kiu/SevenBlocks/bom.ods

Ordered | Description | Qty | Price | Price (sum) | Id | Link
x | Zahnrad Z18/M1/B4 | 29 | 0.60 € | 17.40 € | OT840044 | http://www.eiwa-es.de
x | 10x Kunststoffzahnstange Modul 1 | 3 | 2.60 € | 7.80 € | TR35.026.0 | http://www.eiwa-es.de
x | Shipping | 1 | 4.95 € | 4.95 € | - | http://www.eiwa-es.de
x | 600x300x3 black 9H01 | 3 |  |  | - | http://www.plexihandel.de
x | 600x300x3 red 3H01 | 3 |  |  | - | http://www.plexihandel.de
x | 600x300x3 transparent XT | 1 |  |  | - | http://www.plexihandel.de
x | Shipping | 1 |  |  | - | http://www.plexihandel.de
x | Sum | 1 | 78.00 € | 78.00 € | - | http://www.plexihandel.de
x | Laser usage (3h) | 1 | 100.00 € | 100.00 € | - | http://www.fablab-muenchen.de
x | ACRIFIX®, Klebstoff, 1S 0116 | 1 | 9.49 € | 9.49 € | - | http://www.ebay.de
x | Shipping | 1 | 3.50 € | 3.50 € | - | http://www.ebay.de
x | HXT500 | 29 | 2.66 € | 77.14 € | HXT500 | http://www.hobbyking.com
x | Shipping | 1 | 20.50 € | 20.50 € | - | http://www.hobbyking.com
x | Customs duty | 1 | 18.55 € | 18.55 € | - | http://www.hobbyking.com
x | 50X DIN 912 A2 M3X6 SB | 1 | 4.99 € | 4.99 € | 912236SB | http://www.screwsandmore.de
x | 25x DIN 912 A2 M4X8 SB | 1 | 4.49 € | 4.49 € | 912248SB | http://www.screwsandmore.de
x | 25x DIN 125 A2 3,2 SB | 1 | 1.49 € | 1.49 € | 125232SB | http://www.screwsandmore.de
x | 50x DIN 125 A2 3,2 SB | 2 | 2.49 € | 4.98 € | 125232SB | http://www.screwsandmore.de
x | Shipping | 1 | 4.50 € | 4.50 € | - | http://www.screwsandmore.de
x | 120x DIN 912 A2 M3x4 | 1 | 26.74 € | 26.74 € | 1448 | http://www.pfahl-verbindungstechnik.de
x | C-Control DCF-Empfängerplatine | 1 | 10.21 € | 10.21 € | 641138-62 | http://www.conrad.de
x | Pinhead 1x3 | 34 | 0.06 € | 2.04 € | 741565 | http://www.conrad.de
x | Pinhead 1x5 | 1 | 0.10 € | 0.10 € | 741605 | http://www.conrad.de
x | Pinhead 1x7 W | 1 | 0.26 € | 0.26 € | 733901 | http://www.conrad.de
x | Socket 1x5 | 1 | 0.42 € | 0.42 € | 732331 | http://www.conrad.de
x | Shipping | 1 | 5.95 € | 5.95 € | - | http://www.conrad.de
x | 10x PCB 50mmx50mm red | 3 | 15.60 € | 46.80 € | PCB08511P | http://www.seeedstudio.com/depot/fusion-pcb-service-p-835.html?cPath=185
x | Shipping | 1 |  |  | - | http://www.seeedstudio.com/depot/fusion-pcb-service-p-835.html?cPath=185
x | Customs duty | 1 | 8.89 € | 8.89 € | - | http://www.seeedstudio.com/depot/fusion-pcb-service-p-835.html?cPath=185
x | Lautsprecherlitze, 2x0,75mm², transp., 5m-Ring | 1 | 1.15 € | 1.15 € | LAT 275-5 | http://www.reichelt.de
x | Mini Schaltnetzteil, geschlossen, 5V/5,0A/25W | 1 | 10.40 € | 10.40 € | SNT MW25-05M | http://www.reichelt.de
x | Netzkabel m. Schutzkontaktstecker, 1,5m, schw. | 1 | 1.90 € | 1.90 € | NKS 150 SW | http://www.reichelt.de
x | SMD LM 75 | 1 | 1.45 € | 1.45 € | LM 75 SMD | http://www.reichelt.de | x | LM 75 | 1 | 1.45 € | 1.45 € | LM 75 SMD | http://www.reichelt.de | x | LM 75 | 1 | 1.45 € | 1.45 € | LM 75 SMD | http://www.reichelt.de | x | LM 75 | 1 | 1.45 € | 1.45 € | LM 75 SMD | http://www.reichelt.de | x | LM 75 | 1 | 1.45 € | 1.45 € | LM 75 SMD | http://www.reichelt.de | x | LM 75 | 1 | 1.45 € | 1.45 € | LM 75 SMD | http://www.reichelt.de | x | LM 75 | 1 | 1.45 € | 1.45 € | LM 75 SMD | http://www.reichelt.de | x | LM 75 | 1 | 1.45 € | 1.45 € | LM 75 SMD | http://www.reichelt.de | x | LM 75 | 1 | 1.45 €
x | SMD ATMega8 TQFP-32 | 2 | 2.30 € | 4.60 € | ATMEGA 8-16 TQ | http://www.reichelt.de
x | SMD 74HC595 | 4 | 0.26 € | 1.04 € | SMD HC 595 | http://www.reichelt.de
x | SMD 100nF | 14 | 0.05 € | 0.70 € | X7R-G0805 100N | http://www.reichelt.de
x | SMD 10nF | 8 | 0.05 € | 0.40 € | X7R-G0805 10N | http://www.reichelt.de
x | SMD Elko 100uF 5mm | 10 | 0.16 € | 1.60 € | VF 100/6,3 K-C | http://www.reichelt.de
x | SMD Elko 10uF 4mm | 8 | 0.09 € | 0.72 € | VF 10/16 C-B | http://www.reichelt.de
x | SMD 4k7 | 4 | 0.10 € | 0.40 € | SMD-0805 4,70K | http://www.reichelt.de
x | SMD 10k | 2 | 0.10 € | 0.20 € | SMD-0805 10,0K | http://www.reichelt.de
x | SMD 20k (only 18k available) | 1 | 0.10 € | 0.10 € | SMD-0805 18,0K | http://www.reichelt.de
x | Wannenstecker, 16-polig, gewinkelt | 9 | 0.16 € | 1.44 € | WSL 16W | http://www.reichelt.de
x | Wannenstecker, 10-polig, gewinkelt | 3 | 0.13 € | 0.39 € | WSL 10W | http://www.reichelt.de
x | Wannenstecker, 6-polig, gerade | 2 | 0.16 € | 0.32 € | WSL 6G | http://www.reichelt.de
x | Pfostenbuchse, 16-polig, mit Zugentlastung | 8 | 0.13 € | 1.04 € | PFL 16 | http://www.reichelt.de
x | Pfostenbuchse, 10-polig, mit Zugentlastung | 2 | 0.08 € | 0.16 € | PFL 10 | http://www.reichelt.de
x | Flachbandkabel AWG28, 16-pol., farb., 3m-Ring | 1 | 4.25 € | 4.25 € | AWG 28-16F 3M | http://www.reichelt.de
x | Flachbandkabel AWG28, 10-pol., farb., 3m-Ring | 1 | 3.00 € | 3.00 € | AWG 28-10F 3M | http://www.reichelt.de
x | Steckbare Anschlussklemme 2-polig, RM5mm | 1 | 0.44 € | 0.44 € | AKL 007-02 | http://www.reichelt.de
x | Stiftleiste für Anschlussklemme 2-polig, RM5mm | 1 | 0.24 € | 0.24 € | STL 017-02 | http://www.reichelt.de
x | Platinensteckverbinder gerade, braun, 3-polig | 2 | 0.34 € | 0.68 € | PS 25/3G BR | http://www.reichelt.de
x | Platinensteckverbinder gerade, braun, 5-polig | 1 | 0.56 € | 0.56 € | PS 25/5G BR | http://www.reichelt.de
x | Hirschmann-Sicherheitseinbaubuchse 4mm, rt | 1 | 1.90 € | 1.90 € | SEB 2600 RT | http://www.reichelt.de
x | Hirschmann-Sicherheitseinbaubuchse 4mm, sw | 1 | 1.90 € | 1.90 € | SEB 2600 SW | http://www.reichelt.de
x | Stufen-Drehschalter, 1 Pol, 12 Stellungen | 1 | 1.65 € | 1.65 € | DS 1 | http://www.reichelt.de
x | Aluminium-Geräteknopf für 6mm-Achse, schwarz | 1 | 1.85 € | 1.85 € | KNOPF 20-6 ALS | http://www.reichelt.de
x | Distanzhülsen, Metall, 6-Kant, M3, 8mm | 58 | 0.08 € | 4.87 € | DI 8MM | http://www.reichelt.de
x | Distanzhülsen, Metall, 6-Kant, M3, 10mm | 24 | 0.10 € | 2.30 € | DI 10MM | http://www.reichelt.de
x | Distanzhülsen, Metall, 6-Kant, M4, 15mm | 6 | 0.16 € | 0.96 € | DI4 15MM | http://www.reichelt.de
x | Distanzhülsen, Metall, 6-Kant, M4, 15mm | 14 | 0.22 € | 3.08 € | DA4 15MM | http://www.reichelt.de
x | Distanzhülsen, Metall, 6-Kant, M4, 20mm | 8 | 0.30 € | 2.40 € | DA4 20MM | http://www.reichelt.de
x | Kabelbinder | 1 | 0.99 € | 0.99 € | KAB-U 140-3,5 | http://www.reichelt.de
x | Shipping | 1 | 5.60 € | 5.60 € | - | http://www.reichelt.de
x | RTC | 1 | 15.00 € | 15.00 € | 281 | http://www.tinkersoup.de
x | Shipping | 1 | 4.50 € | 4.50 € | - | http://www.tinkersoup.de
 |  |  |  | SUM
 |  |  |  | 543.38 €
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
