kiu/SevenBlocks/acryl/laser-v1-protptype/muster.dxf

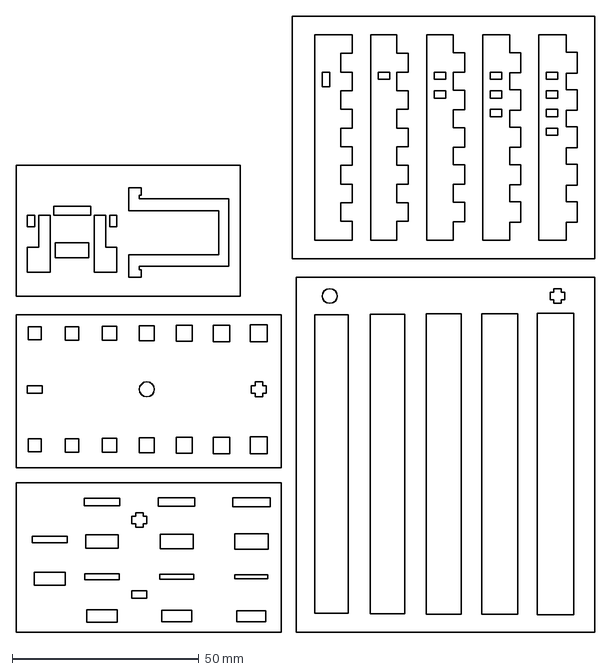
[picture p1: CAD file, 2012-04-07]
acryl/laser-v1-protptype/muster.dxf
155.0 x 165.0 mm
