kiu/SevenBlocks/acryl/laser-v2-design/sides.dxf

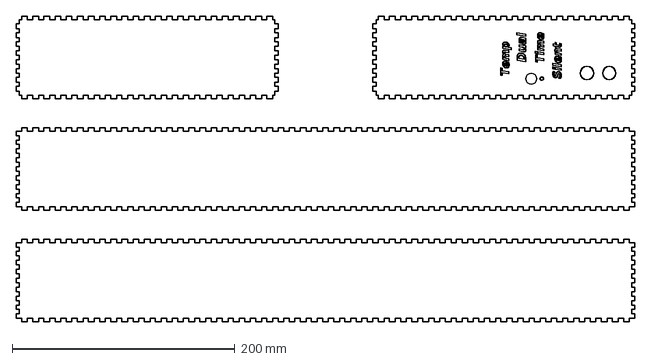
[picture p2: CAD file, 2012-04-07]
acryl/laser-v2-design/sides.dxf
555.0 x 274.0 mm
