kiu/SevenBlocks/acryl/laser-v3-final/red-01.dxf

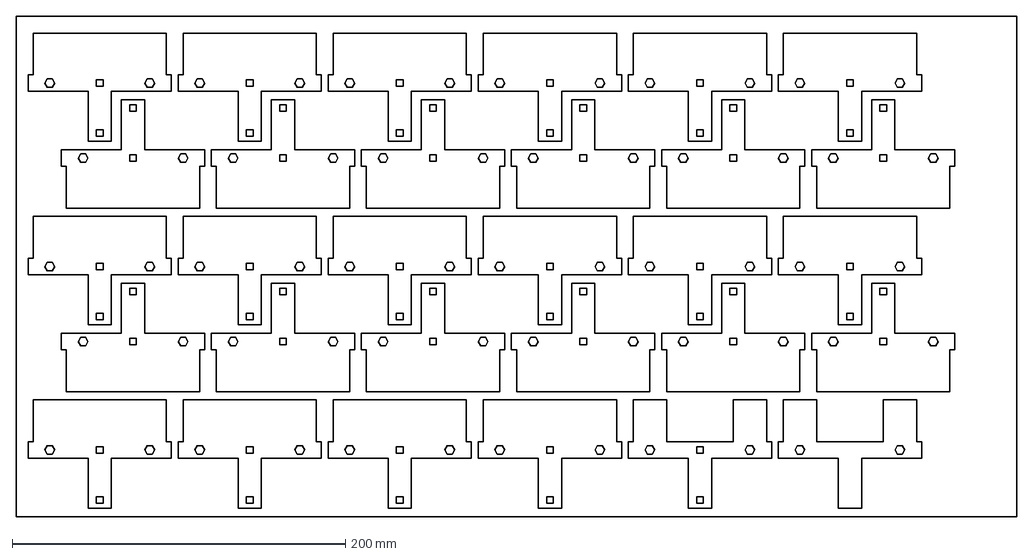
[picture p3: CAD file, 2012-04-07]
acryl/laser-v3-final/red-01.dxf
600.0 x 300.0 mm
