kiu/SevenBlocks/acryl/laser-v2-design/layers-single.dxf

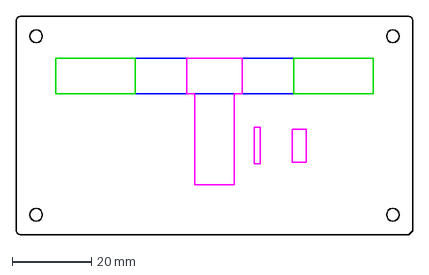
[picture p5: CAD file, 2012-04-07]
acryl/laser-v2-design/layers-single.dxf
100.0 x 55.0 mm
