kiu/SevenBlocks/acryl/laser-v1-protptype/plate2.dxf

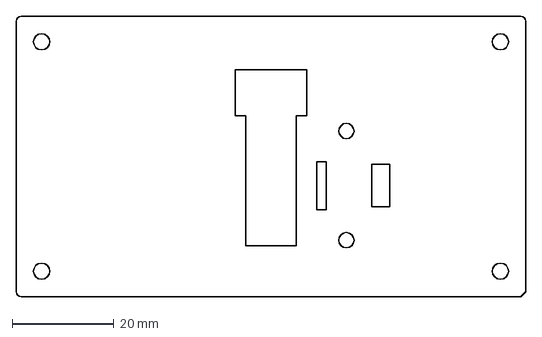
[picture p7: CAD file, 2012-04-07]
acryl/laser-v1-protptype/plate2.dxf
100.0 x 55.0 mm
