kiu/SevenBlocks/acryl/laser-v2-design/layers.dxf

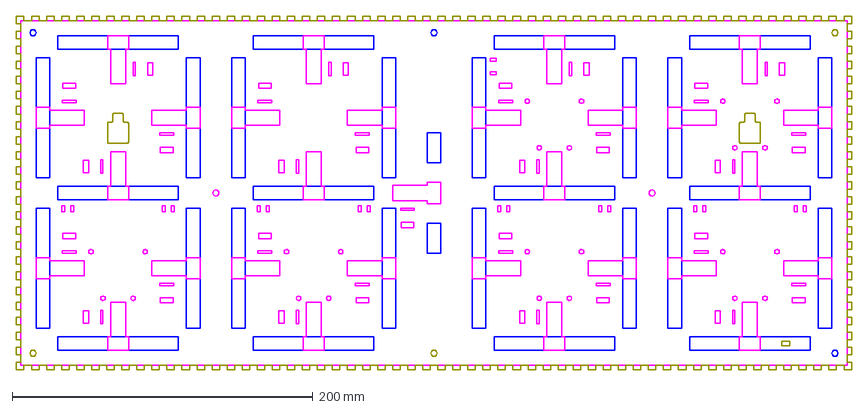
[picture p8: CAD file, 2012-04-07]
acryl/laser-v2-design/layers.dxf
555.0 x 235.0 mm
