kiu/SevenBlocks/acryl/laser-v1-protptype/block1.dxf

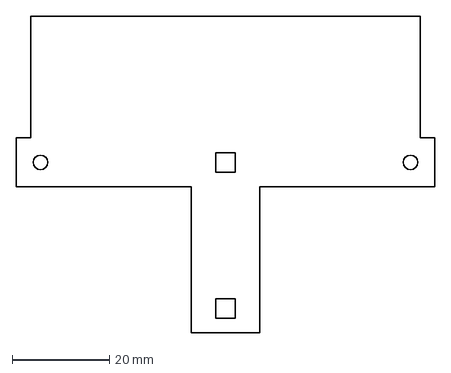
[picture p10: CAD file, 2012-04-07]
acryl/laser-v1-protptype/block1.dxf
86.0 x 65.0 mm
