kiu/SevenBlocks/acryl/laser-v2-design/blocks.dxf

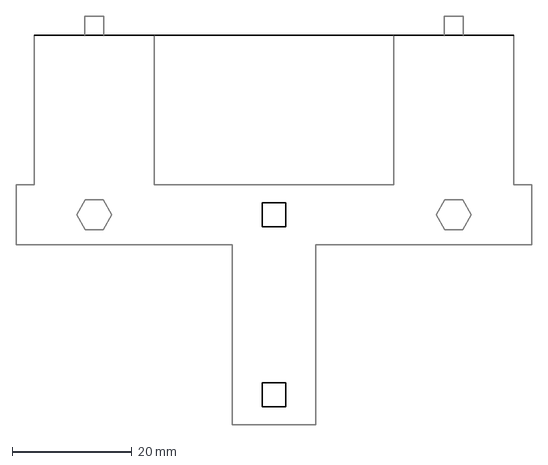
[picture p11: CAD file, 2012-04-07]
acryl/laser-v2-design/blocks.dxf
86.0 x 68.1 mm
