kiu/SevenBlocks/acryl/laser-v3-final/red-03l.dxf

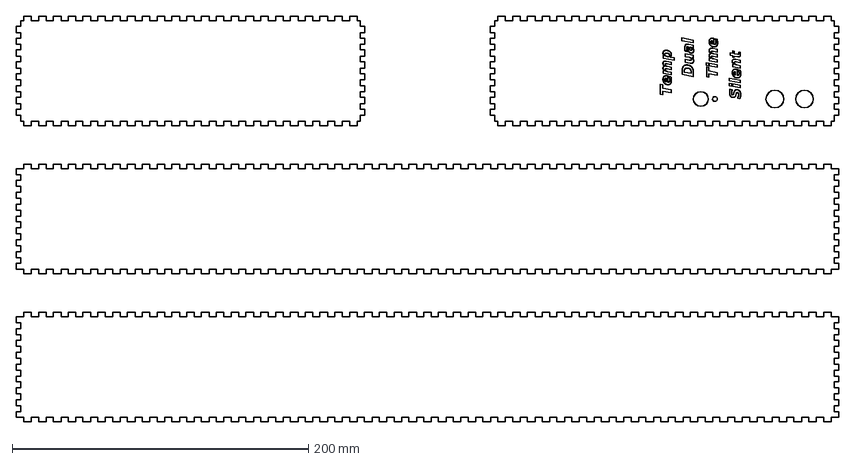
[picture p12: CAD file, 2012-04-07]
acryl/laser-v3-final/red-03l.dxf
555.0 x 274.0 mm
