kiu/SevenBlocks/acryl/laser-v3-final/black-02.dxf

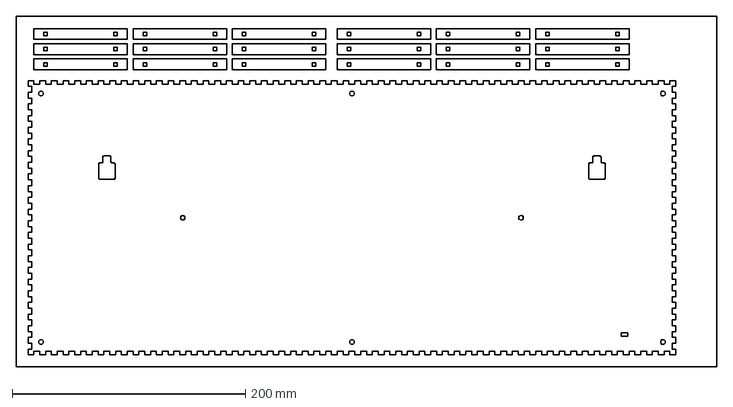
[picture p13: CAD file, 2012-04-07]
acryl/laser-v3-final/black-02.dxf
600.0 x 300.0 mm
