kiu/SevenBlocks/acryl/laser-v3-final/red-03r.dxf

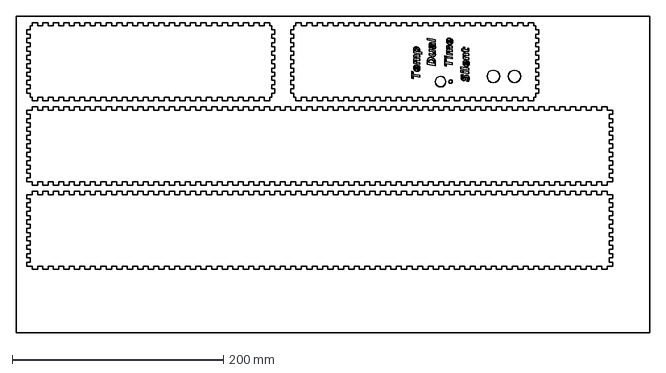
[picture p15: CAD file, 2012-04-07]
acryl/laser-v3-final/red-03r.dxf
600.0 x 300.0 mm
