kiu/SevenBlocks/acryl/laser-v3-final/red-02.dxf

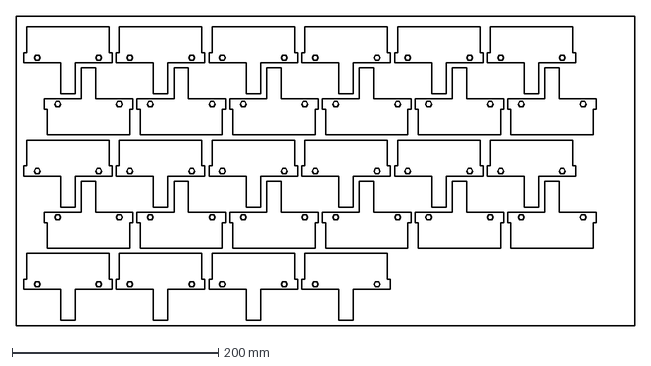
[picture p16: CAD file, 2012-04-07]
acryl/laser-v3-final/red-02.dxf
600.0 x 300.0 mm
