kiu/SevenBlocks/pcb/servoreference.brd

## EAGLE design pcb/servoreference.brd (2012-04-07)

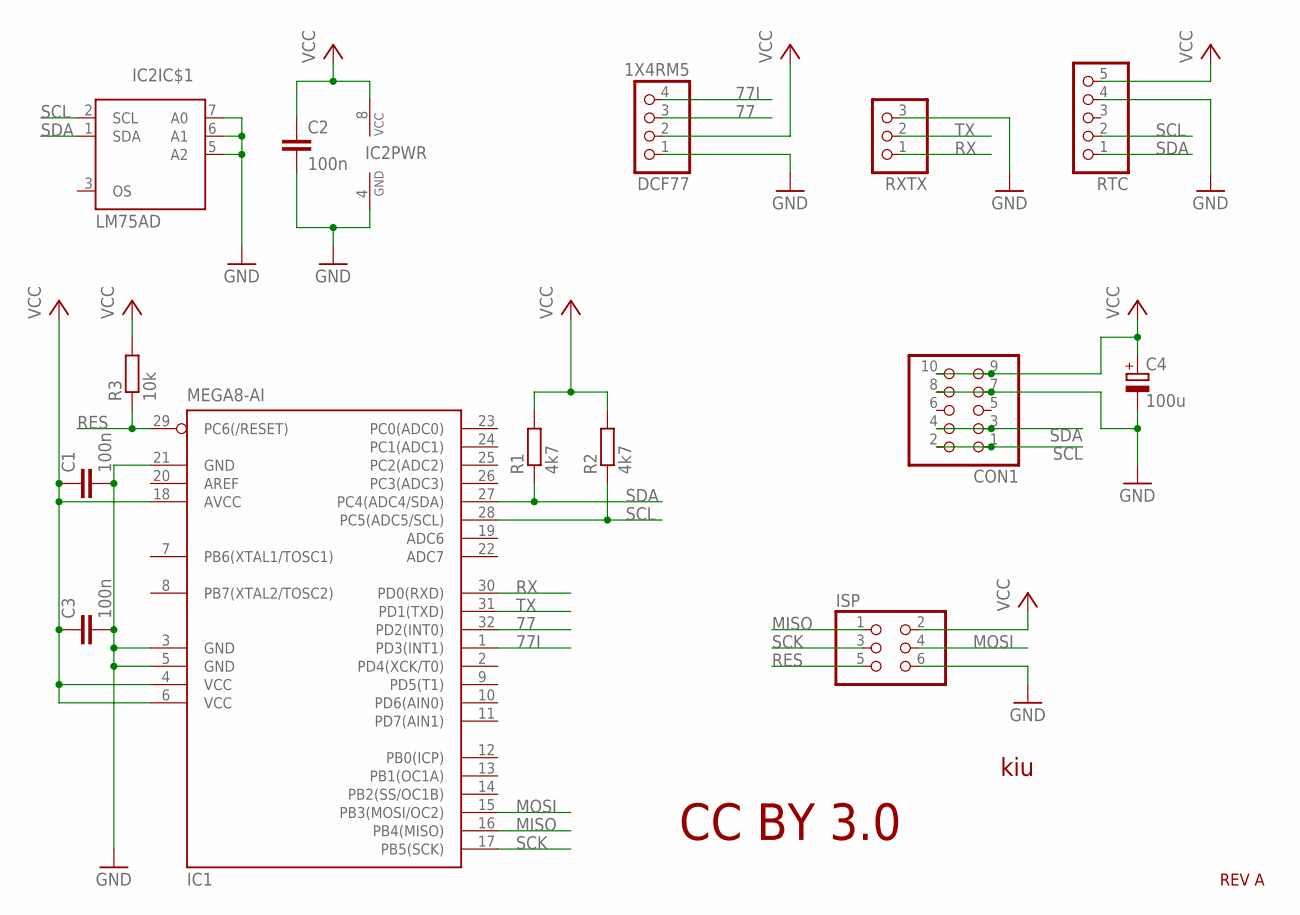
[picture p17: schematic servoreference.sch]

Parts:
C1, C2, C3: 100n; C0805
C4: 100u; 153CLV-0505
CON1: PINHD-2X5; 2X05
DCF77: 1X4RM5
IC1: MEGA8-AI; TQFP32-08; MPN ATMEGA8-16AU
IC2: LM75AD; SO08
ISP: PINHD-2X3; 2X03
R1, R2: 4k7; R0805
R3: 10k; R0805
RTC: PINHD-1X5; 1X05
RXTX: PINHD-1X3; 1X03

Connections:
77: DCF77.3, IC1.32 (PD2(INT0))
77I: DCF77.4, IC1.1 (PD3(INT1))
GND: C1.2, C2.2, C3.2, C4.-, CON1.7, CON1.8, DCF77.1, IC1.3 (GND), IC1.5 (GND), IC1.21 (GND), IC2.4 (GND), IC2.5 (A2), IC2.6 (A1), IC2.7 (A0), ISP.6, RTC.4, RXTX.3
MISO: IC1.16 (PB4(MISO)), ISP.1
MOSI: IC1.15 (PB3(MOSI/OC2)), ISP.4
RES: IC1.29 (PC6(/RESET)), ISP.5, R3.1
RX: IC1.30 (PD0(RXD)), RXTX.1
SCK: IC1.17 (PB5(SCK)), ISP.3
SCL: CON1.1, CON1.2, IC1.28 (PC5(ADC5/SCL)), IC2.2 (SCL), R2.1, RTC.2
SDA: CON1.3, CON1.4, IC1.27 (PC4(ADC4/SDA)), IC2.1 (SDA), R1.1, RTC.1
TX: IC1.31 (PD1(TXD)), RXTX.2
VCC: C1.1, C2.1, C3.1, C4.+, CON1.9, CON1.10, DCF77.2, IC1.4 (VCC), IC1.6 (VCC), IC1.18 (AVCC), IC2.8 (VCC), ISP.2, R1.2, R2.2, R3.2, RTC.5

Notes on the sheet:
CC BY 3.0
kiu
REV A

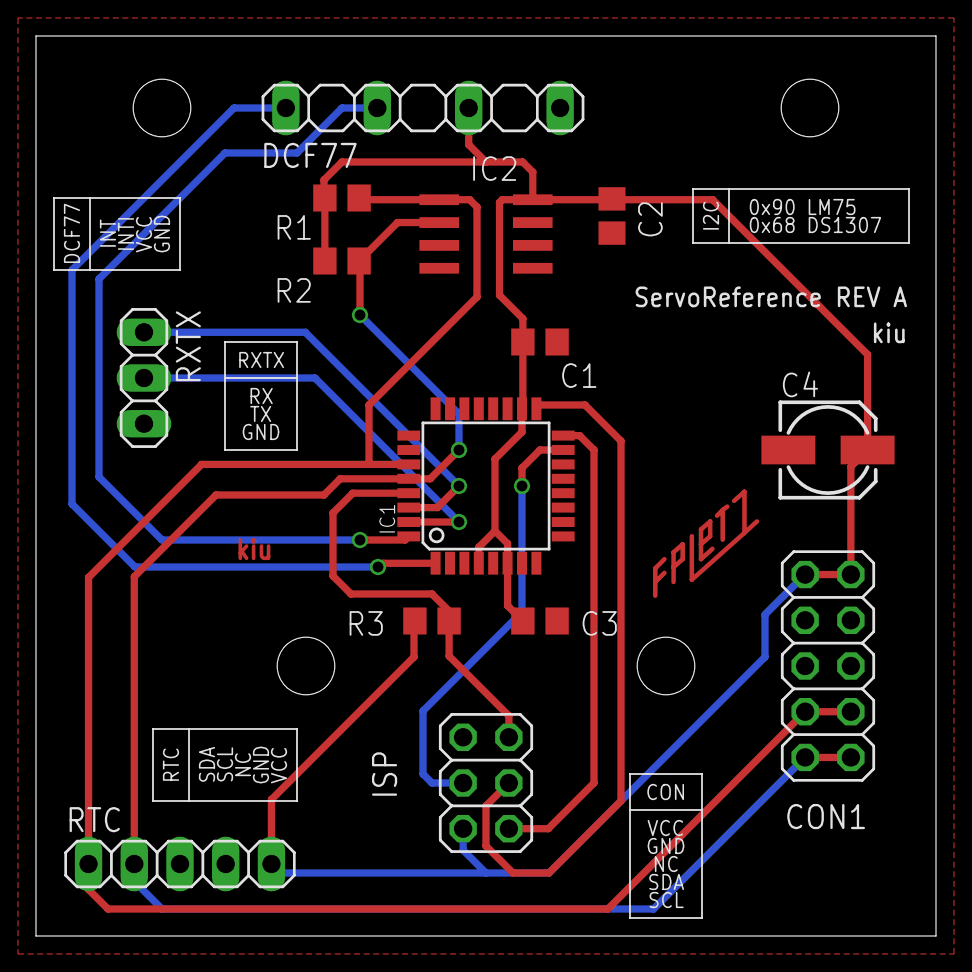
[picture p18: board servoreference.brd from above]

Board: 2 copper layers, 50.0 x 50.0 mm, 14 parts (0 on the bottom side), 12 nets.
