kiu/SevenBlocks/pcb/servocontrol.brd

## EAGLE design pcb/servocontrol.brd (2012-04-07)

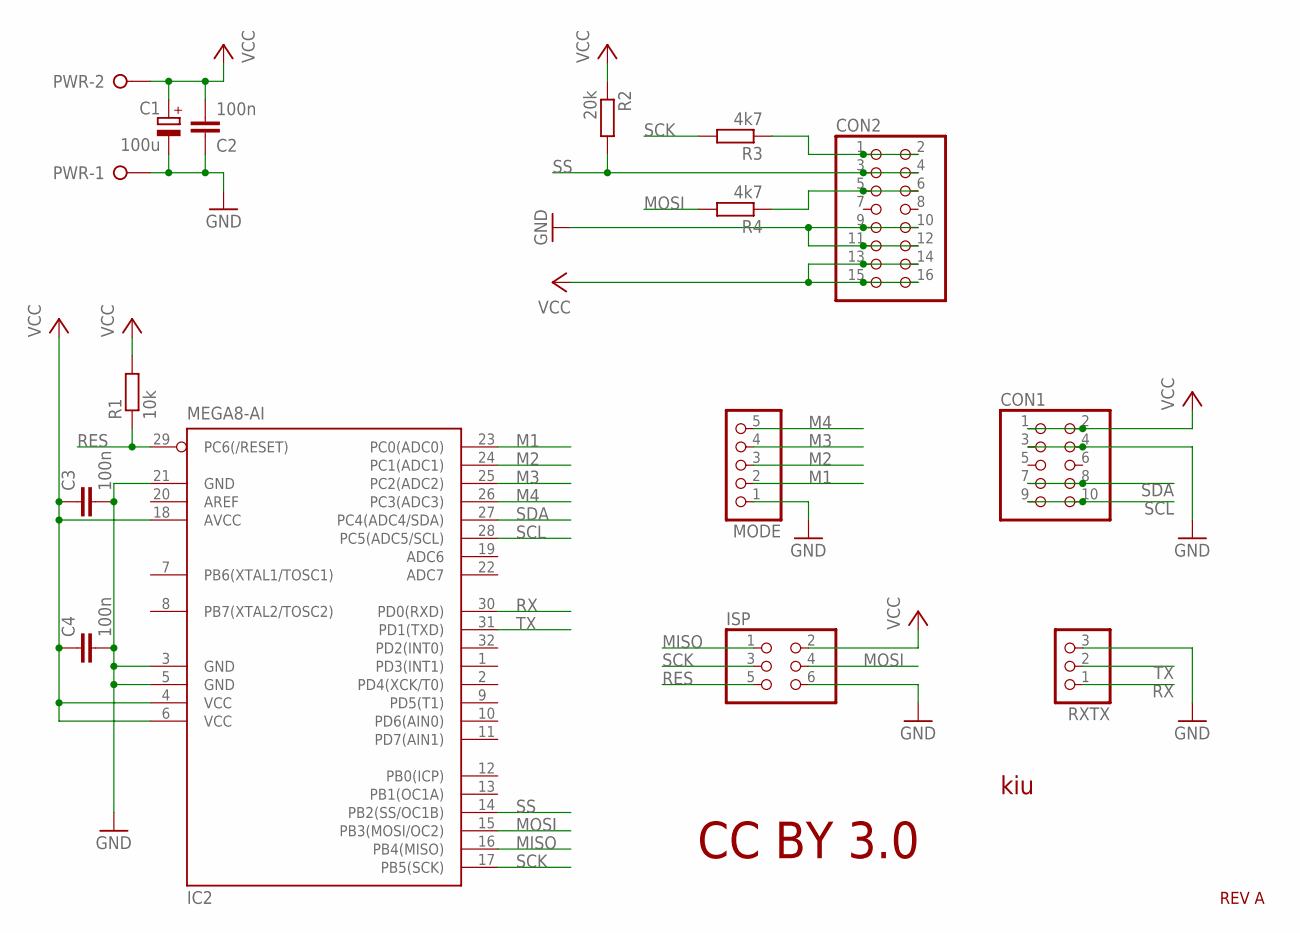
[picture p19: schematic servocontrol.sch]

Parts:
C1: 100u; 153CLV-0505
C2, C3, C4: 100n; C0805
CON1: PINHD-2X5; 2X05
CON2: PINHD-2X8; 2X08
IC2: MEGA8-AI; TQFP32-08; MPN ATMEGA8-16AU
ISP: PINHD-2X3; 2X03
MODE: PINHD-1X5; 1X05
PWR: W237-02P; W237-132
R1: 10k; R0805
R2: 20k; R0805
R3, R4: 4k7; R0805
RXTX: PINHD-1X3; 1X03

Connections:
GND: C1.-, C2.1, C3.2, C4.2, CON1.3, CON1.4, CON2.9, CON2.10, CON2.11, CON2.12, IC2.3 (GND), IC2.5 (GND), IC2.21 (GND), ISP.6, MODE.1, PWR.1, RXTX.3
M1: IC2.23 (PC0(ADC0)), MODE.2
M2: IC2.24 (PC1(ADC1)), MODE.3
M3: IC2.25 (PC2(ADC2)), MODE.4
M4: IC2.26 (PC3(ADC3)), MODE.5
MISO: IC2.16 (PB4(MISO)), ISP.1
MOSI: IC2.15 (PB3(MOSI/OC2)), ISP.4, R4.2
unnamed: CON2.5, CON2.6, R4.1
unnamed: CON2.1, CON2.2, R3.1
RES: IC2.29 (PC6(/RESET)), ISP.5, R1.1
RX: IC2.30 (PD0(RXD)), RXTX.1
SCK: IC2.17 (PB5(SCK)), ISP.3, R3.2
SCL: CON1.9, CON1.10, IC2.28 (PC5(ADC5/SCL))
SDA: CON1.7, CON1.8, IC2.27 (PC4(ADC4/SDA))
SS: CON2.3, CON2.4, IC2.14 (PB2(SS/OC1B)), R2.2
TX: IC2.31 (PD1(TXD)), RXTX.2
VCC: C1.+, C2.2, C3.1, C4.1, CON1.1, CON1.2, CON2.13, CON2.14, CON2.15, CON2.16, IC2.4 (VCC), IC2.6 (VCC), IC2.18 (AVCC), ISP.2, PWR.2, R1.2, R2.1

Notes on the sheet:
CC BY 3.0
kiu
REV A

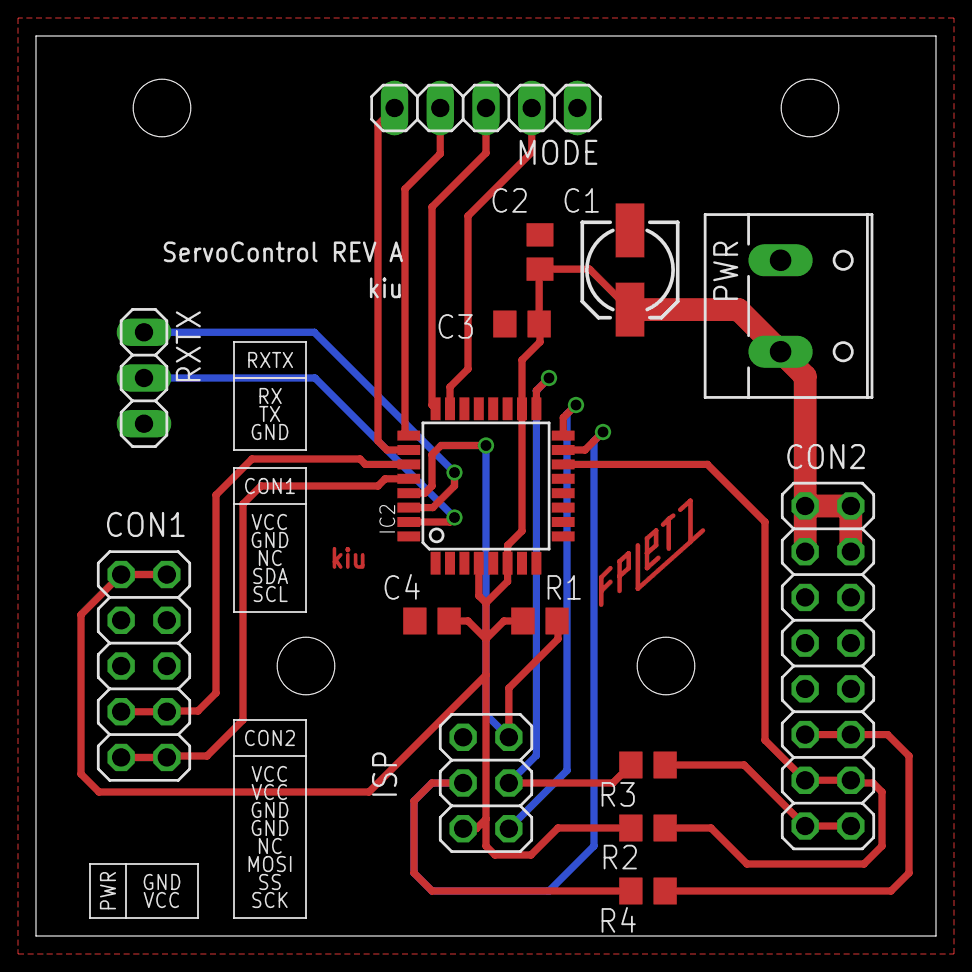
[picture p20: board servocontrol.brd from above]

Board: 2 copper layers, 50.0 x 50.0 mm, 15 parts (0 on the bottom side), 17 nets.
