kiu/SevenBlocks/pcb/servoshifter.brd

## EAGLE design pcb/servoshifter.brd (2012-04-07)

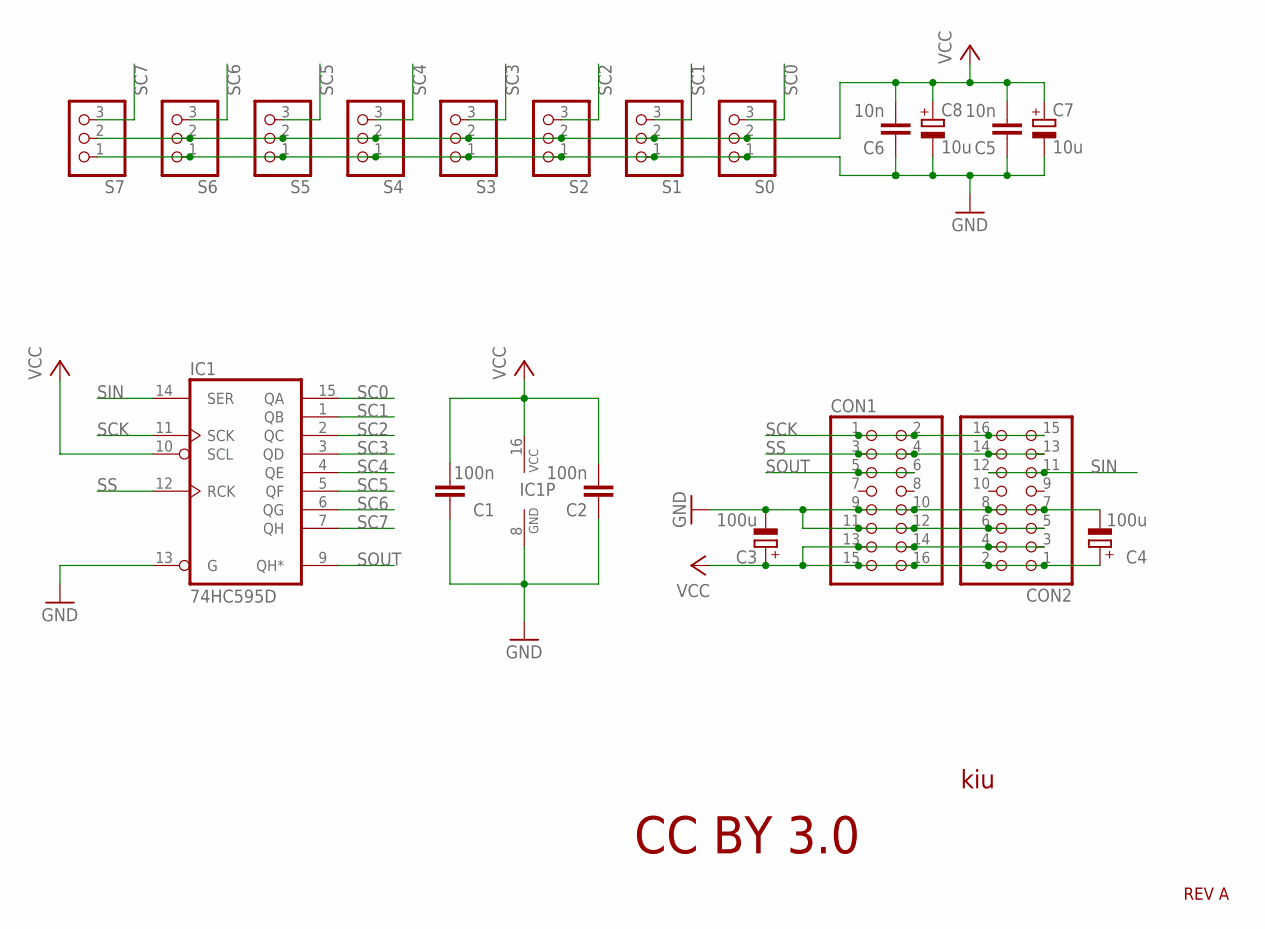
[picture p21: schematic servoshifter.sch]

Parts:
C1, C2: 100n; C0805
C3, C4: 100u; 153CLV-0505
C5, C6: 10n; C0805
C7, C8: 10u; 153CLV-0405
CON1, CON2: PINHD-2X8; 2X08
IC1: 74HC595D; SO16
S0, S1, S2, S3, S4, S5, S6, S7: PINHD-1X3; 1X03

Connections:
GND: C1.1, C2.1, C3.-, C4.-, C5.1, C6.1, C7.-, C8.-, CON1.9, CON1.10, CON1.11, CON1.12, CON2.5, CON2.6, CON2.7, CON2.8, IC1.8 (GND), IC1.13 (G), S0.1, S1.1, S2.1, S3.1, S4.1, S5.1, S6.1, S7.1
SC0: IC1.15 (QA), S0.3
SC1: IC1.1 (QB), S1.3
SC2: IC1.2 (QC), S2.3
SC3: IC1.3 (QD), S3.3
SC4: IC1.4 (QE), S4.3
SC5: IC1.5 (QF), S5.3
SC6: IC1.6 (QG), S6.3
SC7: IC1.7 (QH), S7.3
SCK: CON1.1, CON1.2, CON2.15, CON2.16, IC1.11 (SCK)
SIN: CON2.11, CON2.12, IC1.14 (SER)
SOUT: CON1.5, CON1.6, IC1.9 (QH*)
SS: CON1.3, CON1.4, CON2.13, CON2.14, IC1.12 (RCK)
VCC: C1.2, C2.2, C3.+, C4.+, C5.2, C6.2, C7.+, C8.+, CON1.13, CON1.14, CON1.15, CON1.16, CON2.1, CON2.2, CON2.3, CON2.4, IC1.10 (SCL), IC1.16 (VCC), S0.2, S1.2, S2.2, S3.2, S4.2, S5.2, S6.2, S7.2

Notes on the sheet:
CC BY 3.0
kiu
REV A

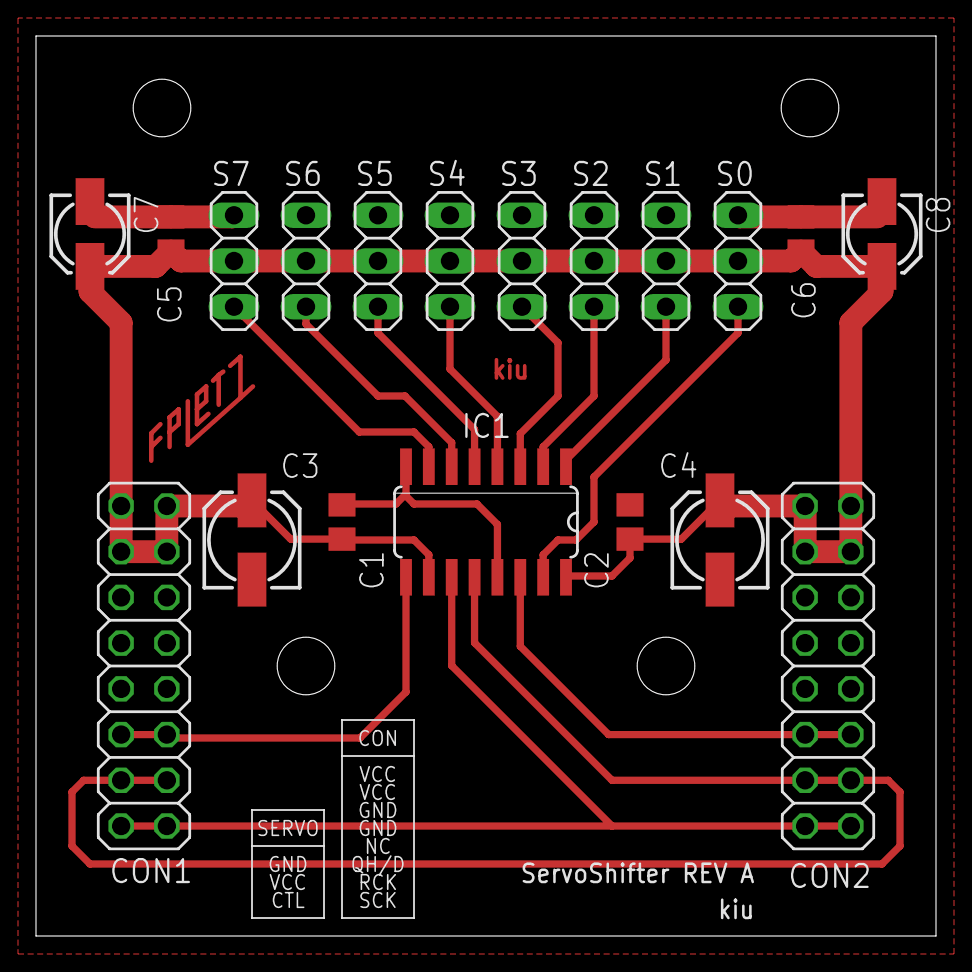
[picture p22: board servoshifter.brd from above]

Board: 2 copper layers, 50.0 x 50.0 mm, 19 parts (0 on the bottom side), 14 nets.
